jvok94/u235/fm2/fm2.kicad_pcb

## KiCad design fm2/fm2.kicad_pcb (2020-06-21)

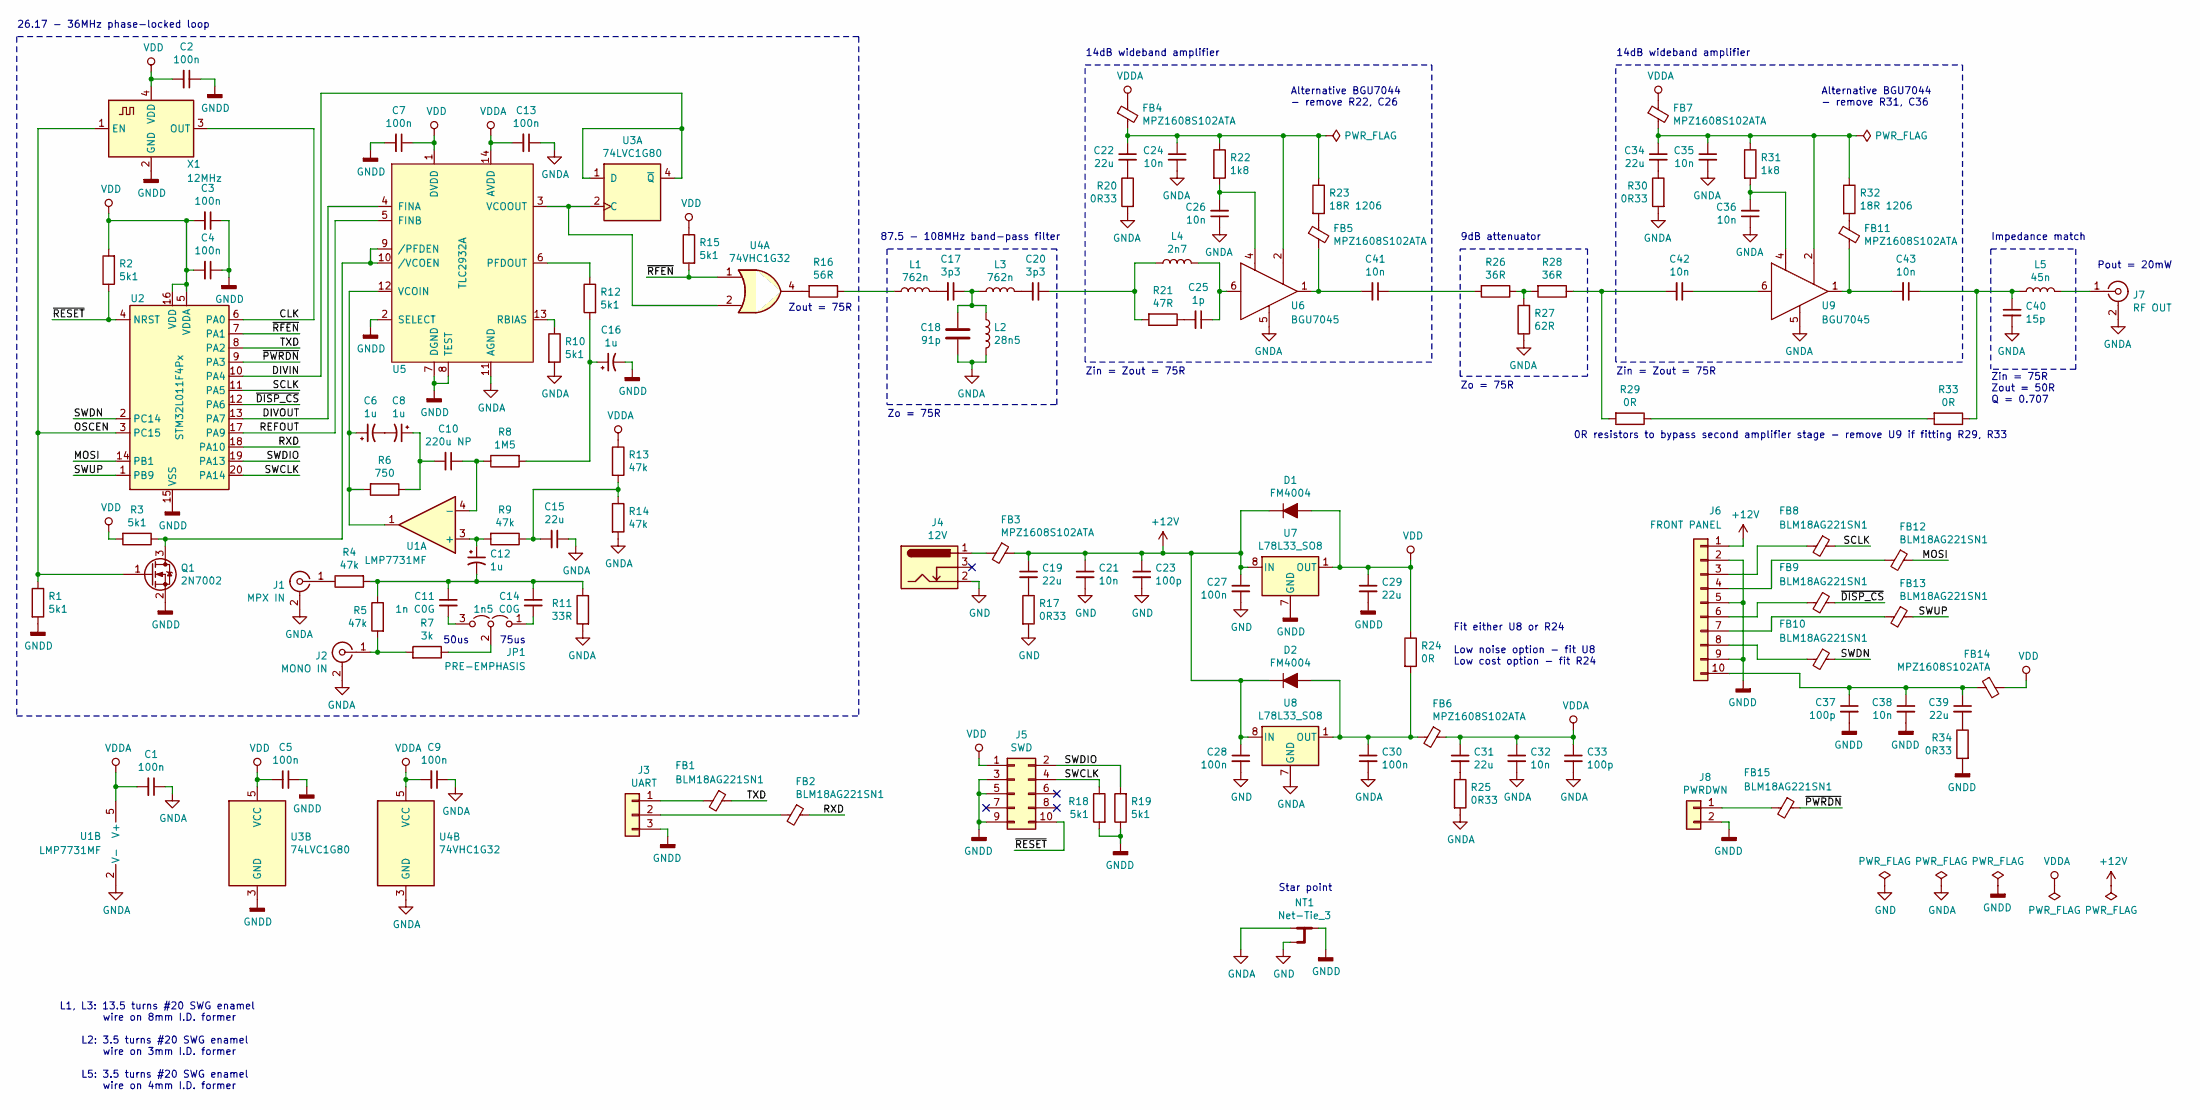
[picture p1: schematic fm2.sch, FM PLL Exciter]

Parts:
C1, C2, C3, C4, C5, C7, C9, C13, C27, C28, C30: 100n; C_0603_HandSoldering
C6, C8, C12, C16: 1u; CP_Radial_D5.0mm_P2.00mm
C10: 220u NP; CP_Radial_D8.0mm_P3.50mm
C11: 1n C0G; C_0603_HandSoldering
C14: 1n5 C0G; C_0603_HandSoldering
C15, C19, C22, C29, C31, C34, C39: 22u; C_1206_HandSoldering
C17, C20: 3p3; C_0603_HandSoldering
C18: 91p; C_0603_HandSoldering
C21, C24, C26, C32, C35, C36, C38, C41, C42, C43: 10n; C_0603_HandSoldering
C23, C33, C37: 100p; C_0603_HandSoldering
C25: 1p; C_0603_HandSoldering
C40: 15p; C_0603_HandSoldering
D1, D2: FM4004; D_SMA_Handsoldering
FB1, FB2, FB8, FB9, FB10, FB12, FB13, FB15: BLM18AG221SN1; R_0603_HandSoldering
FB3, FB4, FB5, FB6, FB7, FB11, FB14: MPZ1608S102ATA; R_0603_HandSoldering
J1: MPX IN; NYS354
J2: MONO IN; NYS354
J3: UART; Pin_Header_Straight_1x03_Pitch2.54mm
J4: 12V; BARREL_JACK
J5: SWD; Pin_Header_Straight_2x05_Pitch1.27mm
J6: FRONT PANEL; Pin_Header_Straight_1x10_Pitch2.54mm
J7: RF OUT; bnc-ci
J8: PWRDWN; Pin_Header_Straight_1x02_Pitch2.54mm
JP1: PRE-EMPHASIS; Pin_Header_Straight_1x03_Pitch2.54mm
L1, L3: 762n; Coil_D10mm_L14mm
L2: 28n5; Coil_D5mm_L4mm
L4: 2n7; R_0402_NoSilk
L5: 45n; Coil_D6mm_L4mm
NT1: Net-Tie_3; net_tie_3
Q1: 2N7002; SOT-23_Handsoldering
R1, R2, R3, R10, R12, R15, R18, R19: 5k1; R_0603_HandSoldering
R4, R5, R9, R13, R14: 47k; R_0603_HandSoldering
R6: 750; R_0603_HandSoldering
R7: 3k; R_0603_HandSoldering
R8: 1M5; R_0603_HandSoldering
R11: 33R; R_0603_HandSoldering
R16: 56R; R_0603_HandSoldering
R17, R20, R25, R30, R34: 0R33; R_0603_HandSoldering
R21: 47R; R_0603_HandSoldering
R22, R31: 1k8; R_0603_HandSoldering
R23, R32: 18R 1206; R_1206_HandSoldering
R24, R29, R33: 0R; R_0603_HandSoldering
R26, R28: 36R; R_0603_HandSoldering
R27: 62R; R_0603_HandSoldering
U1: LMP7731MF; SOT-23-5_HandSoldering
U2: STM32L011F4Px; TSSOP-20_4.4x6.5mm_P0.65mm
U3: 74LVC1G80; SOT-23-5_HandSoldering
U4: 74VHC1G32; SOT-753
U5: TLC2932A; TSSOP-14_4.4x5mm_P0.65mm
U6, U9: BGU7045; SOT-363_SC-70-6_Handsoldering
U7, U8: L78L33_SO8; SOIC-8_3.9x4.9mm_P1.27mm
X1: 12MHz; Crystal_SMD_5032-4pin_5.0x3.2mm

Connections:
+12V: C19.1, C21.1, C23.1, C27.1, C28.1, D1.1 (K), D2.1 (K), FB3.1, J6.1, U7.8 (IN), U8.8 (IN)
/CLK: U2.6 (PA0), X1.3 (OUT)
/DIVIN: U2.10 (PA4), U3.1 (D), U3.4 (~Q)
/DIVOUT: U2.13 (PA7), U5.4 (FINA)
/MOSI: FB12.1, U2.14 (PB1)
/OSCEN: Q1.1 (G), R1.1, U2.3 (PC15), X1.1 (EN)
/REFOUT: U2.17 (PA9), U5.5 (FINB)
/RXD: FB2.1, U2.18 (PA10)
/SCLK: FB8.1, U2.11 (PA5)
/SWCLK: J5.4, R18.1, U2.20 (PA14)
/SWDIO: J5.2, R19.2, U2.19 (PA13)
/SWDN: FB10.1, U2.2 (PC14)
/SWUP: FB13.1, U2.1 (PB9)
/TXD: FB1.1, U2.8 (PA2)
/~DISP_CS: FB9.1, U2.12 (PA6)
/~PWRDN: FB15.1, U2.9 (PA3)
/~RESET: J5.10, R2.1, U2.4 (NRST)
/~RFEN: R15.2, U2.7 (PA1), U4.1
GND: C21.2, C23.2, C27.2, C28.2, J4.2, NT1.3, R17.2
GNDA: C1.1, C9.1, C13.1, C15.1, C18.1, C24.2, C26.1, C30.2, C32.2, C33.2, C35.2, C36.1, C40.2, J1.2 (Ext), J2.2 (Ext), J7.2 (Ext), L2.2, NT1.1, R10.2, R11.2, R14.2, R20.2, R25.2, R27.1, R30.2, U1.2 (V-), U4.3 (GND), U5.11 (AGND), U6.5 (GND), U8.2 (GND), U8.3 (GND), U8.6 (GND), U8.7 (GND), U9.5 (GND)
GNDD: C2.1, C3.1, C4.1, C5.1, C7.2, C16.2, C29.2, C37.2, C38.2, J3.3, J5.3, J5.5, J5.9, J6.2, J6.5, J6.9, J8.2, NT1.2, Q1.2 (S), R1.2, R18.2, R19.1, R34.2, U2.15 (VSS), U3.3 (GND), U5.2 (SELECT), U5.7 (DGND), U5.8 (TEST), U7.2 (GND), U7.3 (GND), U7.6 (GND), U7.7 (GND), X1.2 (GND)
unnamed: C6.1, R6.2, U1.1, U5.12 (VCOIN)
unnamed: C6.2, C8.2
unnamed: C10.1, R8.1, U1.4 (-)
unnamed: C8.1, C10.2, R6.1
unnamed: C11.1, C12.2, C14.1, R4.2, R5.1, R11.1
unnamed: C11.2, JP1.3 (B)
unnamed: C12.1, R9.2, U1.3 (+)
unnamed: C14.2, JP1.1 (A)
unnamed: C15.2, R9.1, R13.2, R14.1
unnamed: C16.1, R8.2, R12.2
unnamed: C17.1, C18.2, L2.1, L3.1
unnamed: C17.2, L1.2
unnamed: C19.2, R17.1
unnamed: C20.1, L4.1, R21.2
unnamed: C20.2, L3.2
unnamed: C22.1, C24.1, FB4.2, R22.1, R23.1, U6.2 (VCC)
unnamed: C22.2, R20.1
unnamed: C25.1, L4.2, U6.6 (IN)
unnamed: C25.2, R21.1
unnamed: C26.2, R22.2, U6.4 (CTRL)
unnamed: C30.1, D2.2 (A), FB6.2, R24.2, U8.1 (OUT)
unnamed: C31.2, R25.1
unnamed: C34.1, C35.1, FB7.2, R31.1, R32.1, U9.2 (VCC)
unnamed: C34.2, R30.1
unnamed: C36.2, R31.2, U9.4 (CTRL)
unnamed: C37.1, C38.1, C39.1, FB14.1, J6.10
unnamed: C39.2, R34.1
unnamed: C40.1, C43.1, L5.1, R33.1
unnamed: C41.1, R26.2
unnamed: C41.2, FB5.2, U6.1 (OUT)
unnamed: C42.1, U9.6 (IN)
unnamed: C42.2, R28.1, R29.2
unnamed: C43.2, FB11.2, U9.1 (OUT)
unnamed: FB1.2, J3.1
unnamed: FB2.2, J3.2
unnamed: FB3.2, J4.1
unnamed: FB5.1, R23.2
unnamed: FB8.2, J6.3
unnamed: FB9.2, J6.6
unnamed: FB10.2, J6.8
unnamed: FB11.1, R32.2
unnamed: FB12.2, J6.4
unnamed: FB13.2, J6.7
unnamed: FB15.2, J8.1
unnamed: J1.1 (In), R4.1
unnamed: J2.1 (In), R5.2, R7.2
unnamed: J7.1 (In), L5.2
unnamed: JP1.2 (C), R7.1
unnamed: L1.1, R16.1
unnamed: Q1.3 (D), R3.1, U5.9 (/PFDEN), U5.10 (/VCOEN)
unnamed: R10.1, U5.13 (RBIAS)
unnamed: R12.1, U5.6 (PFDOUT)
unnamed: R16.2, U4.4
unnamed: R26.1, R27.2, R28.2
unnamed: R29.1, R33.2
unnamed: U3.2 (C), U4.2, U5.3 (VCOOUT)
VDD: C2.2, C3.2, C4.2, C5.2, C7.1, C29.1, D1.2 (A), FB14.2, J5.1, R2.2, R3.2, R15.1, R24.1, U2.5 (VDDA), U2.16 (VDD), U3.5 (VCC), U5.1 (DVDD), U7.1 (OUT), X1.4 (VDD)
VDDA: C1.2, C9.2, C13.2, C31.1, C32.1, C33.1, FB4.1, FB6.1, FB7.1, R13.1, U1.5 (V+), U4.5 (VCC), U5.14 (AVDD)

Notes on the sheet:
75us
50us
26.17 - 36MHz phase-locked loop
Zout = 75R
14dB wideband amplifier
Zin = Zout = 75R
Alternative BGU7044 - remove R22, C26
9dB attenuator
Alternative BGU7044 - remove R31, C36
0R resistors to bypass second amplifier stage - remove U9 if fitting R29, R33
Fit either U8 or R24 Low noise option - fit U8 Low cost option - fit R24
Star point
Pout = 20mW
Impedance match
Zin = 75R Zout = 50R Q = 0.707
L1, L3: 13.5 turns #20 SWG enamel wire on 8mm I.D. former L2: 3.5 turns #20 SWG enamel wire on 3mm I.D. former L5: 3.5 turns #20 SWG enamel wire on 4mm I.D. former
Zo = 75R
87.5 - 108MHz band-pass filter

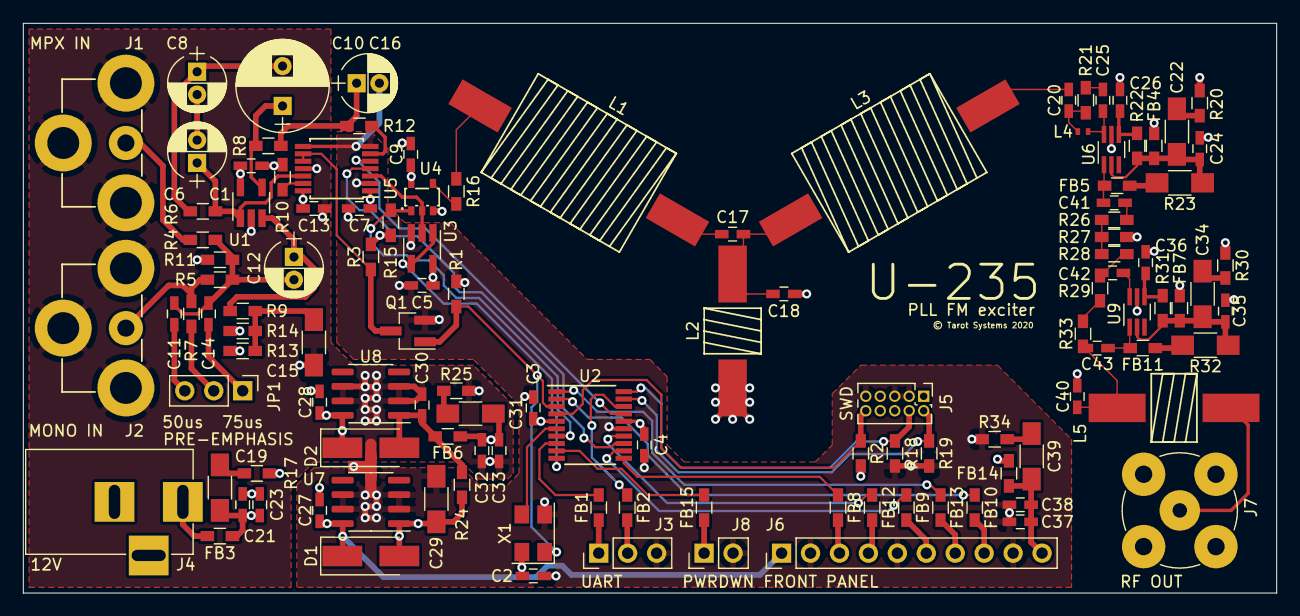
[picture p2: board fm2.kicad_pcb from above]

Board: 4 copper layers, 110.0 x 50.0 mm, 120 parts (0 on the bottom side), 79 nets.
