jvok94/u235/(threads)

Thread 1 (2020-06-21):

Separate power ground pin on J6 for display backlight

jvok94, 2020-06-21:
+12V is brought out to the FRONT PANEL connector (J6) on pin 1 to power a display backlight. The ground associated with this rail is GND (power ground), however all the ground pins on J6 are connected to GNDD (digital ground).

This will still work as the grounds are joined together at star point NT1, but it will create a large loop area into which RF currents could be induced.

Change one of the ground pins on J6 (preferably pin 2) to GND instead of GNDD.

Thread 2 (2020-06-21):

Through holes on J4 are too small

jvok94, 2020-06-21:
Stock BARREL_JACK footprint was used for power input jack (J4), but the holes on this footprints are too small for the pins on the CUI PJ-202B jack, causing it to sit askew. Widen these holes to the dimensions on the PJ-202B datasheet.

Thread 3 (2020-06-21):

No power down on opamp and RF amplifiers

jvok94, 2020-06-21:
Functionality was included to power down the microcontroller (U2), PLL (U5) and crystal oscillator (X1) in response to /PWRDN input (J8). However the PLL filter opamp (U1) and RF amplifiers (U6, U9) remain powered up. This is particularly bad as the RF amplifiers are the most power-hungry part of the system - in total this circuitry will pull 70mA from the 3V3A rail even when powered down. Add circuitry to switch off the power to these devices in power-down mode.

Additionally the 3.3V regulators (U7-8) each draw 6mA quiescent current, which is too much for power-down mode. Consider changing to less power-hungry regulators.
