jvok94/u235/(notices)

Notices in the files:
fm2/fm2.kicad_pcb:
© Tarot Systems 2020
